kaushalch1/air-monitor/bom.csv

Name | Purpose | Quantity | Total Cost (USD) | Link | Distributor
DS3231M+TRL (SOIC-16W) | Real-time clock | 1 | 8.25 | https://www.lcsc.com/product-detail/C37663.html | LCSC
BMP280 | Pressure sensor | 1 | 6.03 | https://www.lcsc.com/product-detail/C83291.html | LCSC
ESP32-S3-WROOM-1-N16R8 | Main MCU (Wi-Fi/BLE) | 1 | 5.54 | https://www.lcsc.com/product-detail/C2913202.html | LCSC
SHT31-DIS-B2.5kS | Temperature/humidity sensor | 1 | 3.41 | https://www.lcsc.com/product-detail/C80862.html | LCSC
0.91 inch OLED (ER-OLEDM0.91-1W-I2C) | Display | 1 | 2.8 | https://www.buydisplay.com/i2c-white-0-91-inch-oled-display-module-128x32-arduino-raspberry-pi | BuyDisplay
BQ24074RGTR | Li-ion battery charger / power path | 1 | 1.59 | https://www.lcsc.com/product-detail/C54313.html | LCSC
microSD socket (DM3AT-SF-PEJM5) | Data logging storage | 1 | 1.12 | https://www.lcsc.com/product-detail/C114218.html | LCSC
USB-C receptacle (TYPE-C-31-M-12) | USB-C charging and data port | 1 | 0.19 | https://www.lcsc.com/product-detail/C165948.html | LCSC
CR2032 holder (CR2032-BS-6-1) | RTC backup battery holder | 1 | 0.15 | https://www.lcsc.com/product-detail/C70377.html | LCSC
AP2112K-3.3TRG1 | 3.3V LDO regulator | 1 | 0.13 | https://www.lcsc.com/product-detail/C51118.html | LCSC
USBLC6-2SC6 | USB ESD protection | 1 | 0.13 | https://www.lcsc.com/product-detail/C7519.html | LCSC
4.7uH inductor 6.3x6.3mm (proxy: Chilisin MHCI06030-4R7M-R8) | Boost converter inductor | 1 | 0.11 | https://www.lcsc.com/product-detail/C108295.html | LCSC
MT3608 | Boost converter | 1 | 0.08 | https://www.lcsc.com/product-detail/C84817.html | LCSC
SS34 Schottky diode (SMA) | Power path / reverse protection diode | 1 | 0.07 | https://www.lcsc.com/product-detail/C2759883.html | LCSC
Tact switch 6mm THT | User buttons | 3 | 0.1 | https://www.lcsc.com/search?q=tactile+switch+6x6+THT | LCSC
1x8 female socket header 2.54mm | Sensor/expansion header | 1 | 0.08 | https://www.lcsc.com/search?q=1x8+female+header+2.54mm | LCSC
10uF capacitor 0805 | Bulk/decoupling capacitors | 4 | 0.19 | https://www.lcsc.com/product-detail/C15850.html | LCSC
Resistors 0805 (5.1k, 890, 1.5k, 10k, 100k, 75k) | Pull-ups, dividers, config resistors | 11 | 0.05 | https://www.lcsc.com/search?q=0805+1%25+resistor | LCSC
1uF capacitor 0805 | Filter capacitors | 3 | 0.04 | https://www.lcsc.com/search?q=CL21B105KBFNNNE | LCSC
4.7uF capacitor 0805 | Filter capacitor | 1 | 0.03 | https://www.lcsc.com/search?q=CL21A475KAQNNNE | LCSC
100nF capacitor 0805 | IC bypass capacitors | 4 | 0.03 | https://www.lcsc.com/product-detail/C1711.html | LCSC
1x2 pin header 2.54mm | Power/battery header | 1 | 0.02 | https://www.lcsc.com/search?q=1x2+pin+header+2.54mm | LCSC
PCB (bare board) | Main PCB | 1 | 0.4 | https://jlcpcb.com/ | JLCPCB
PCB assembly (PCBA fees) | SMT + through-hole assembly fees | 1 | 8.17 | https://jlcpcb.com/ | JLCPCB
 |  |  | 38.71
