kaushalch1/air-monitor/cad files/air monitor.step

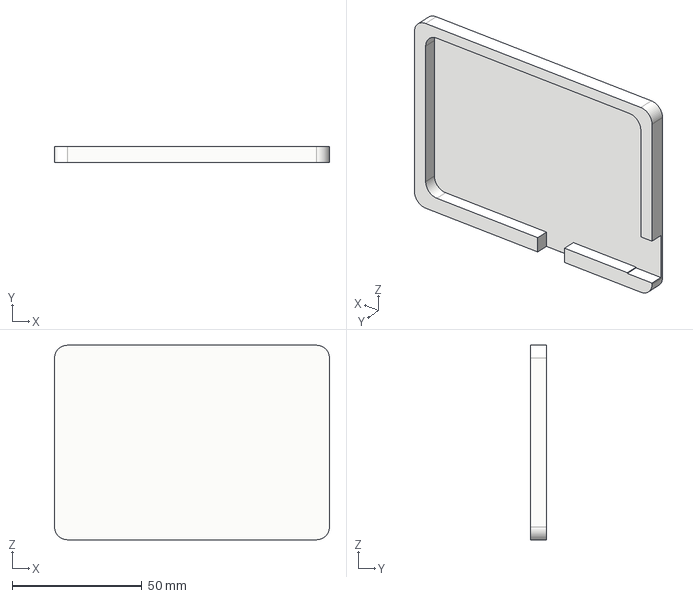
[picture p1: CAD file, 2026-10-24]
cad files/air monitor.step
106.0 x 6.00 x 75.0 mm
