kaushalch1/air-monitor/cad files/air monitor assesmbly model.step

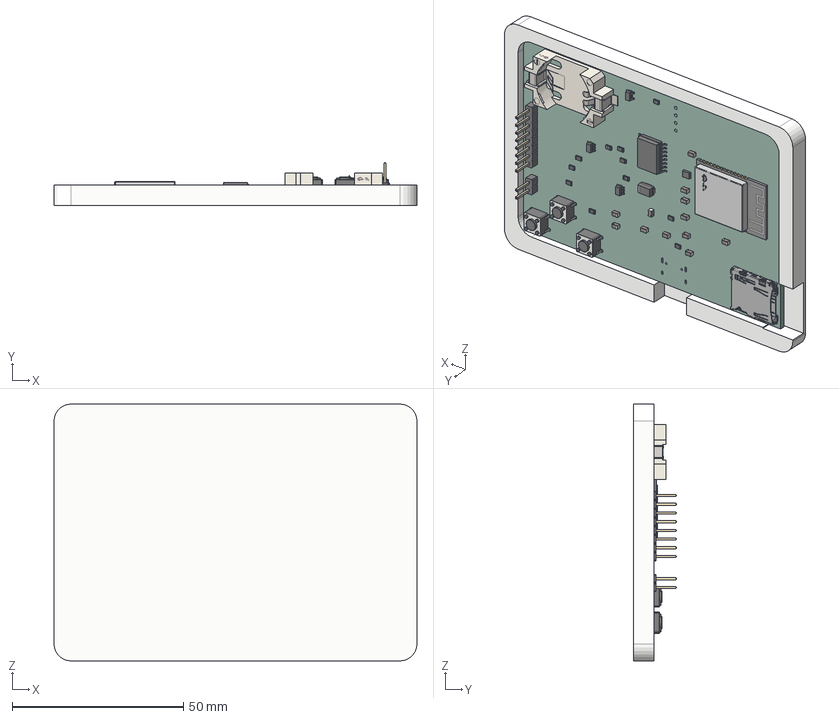
[picture p2: CAD file, 2026-10-24]
cad files/air monitor assesmbly model.step
106.0 x 12.4 x 75.0 mm
SOT-23-6_1 x 2
C_0805_2012Metric_1 x 12
R_0805_2012Metric_1 x 11
BAT-SMD_L28.5-W16.0-H5.5-LS31.3_CR2032-BS-6-1_1
PinHeader_1x08_P254mm_Vertical
SOIC-16W_7.5x10.3mm_P1.27mm_1
D_SMA_1
SW_PUSH_6mm_1 x 3
Bosch_LGA_8_2x25mm_P065mm_ClockwisePinNumbering
PinHeader_1x02_P254mm_Vertical
microSD_HC_Hirose_DM3AT-SF-PEJM5_1
WIRELM-SMD_ESP32-S3-WROOM-1_1
SOT-23-5_1
air monitor_PCB
