kaushalch1/air-monitor/(list of files, cad)

Other CAD files:
cad files/air monitor assesmbly model.f3z
cad files/air monitor.f3d
