kaushalch1/air-monitor/pcb ,gerber files/pcb files/air monitor.kicad_pcb

## KiCad design pcb ,gerber files/pcb files/air monitor.kicad_pcb (2026-10-21)

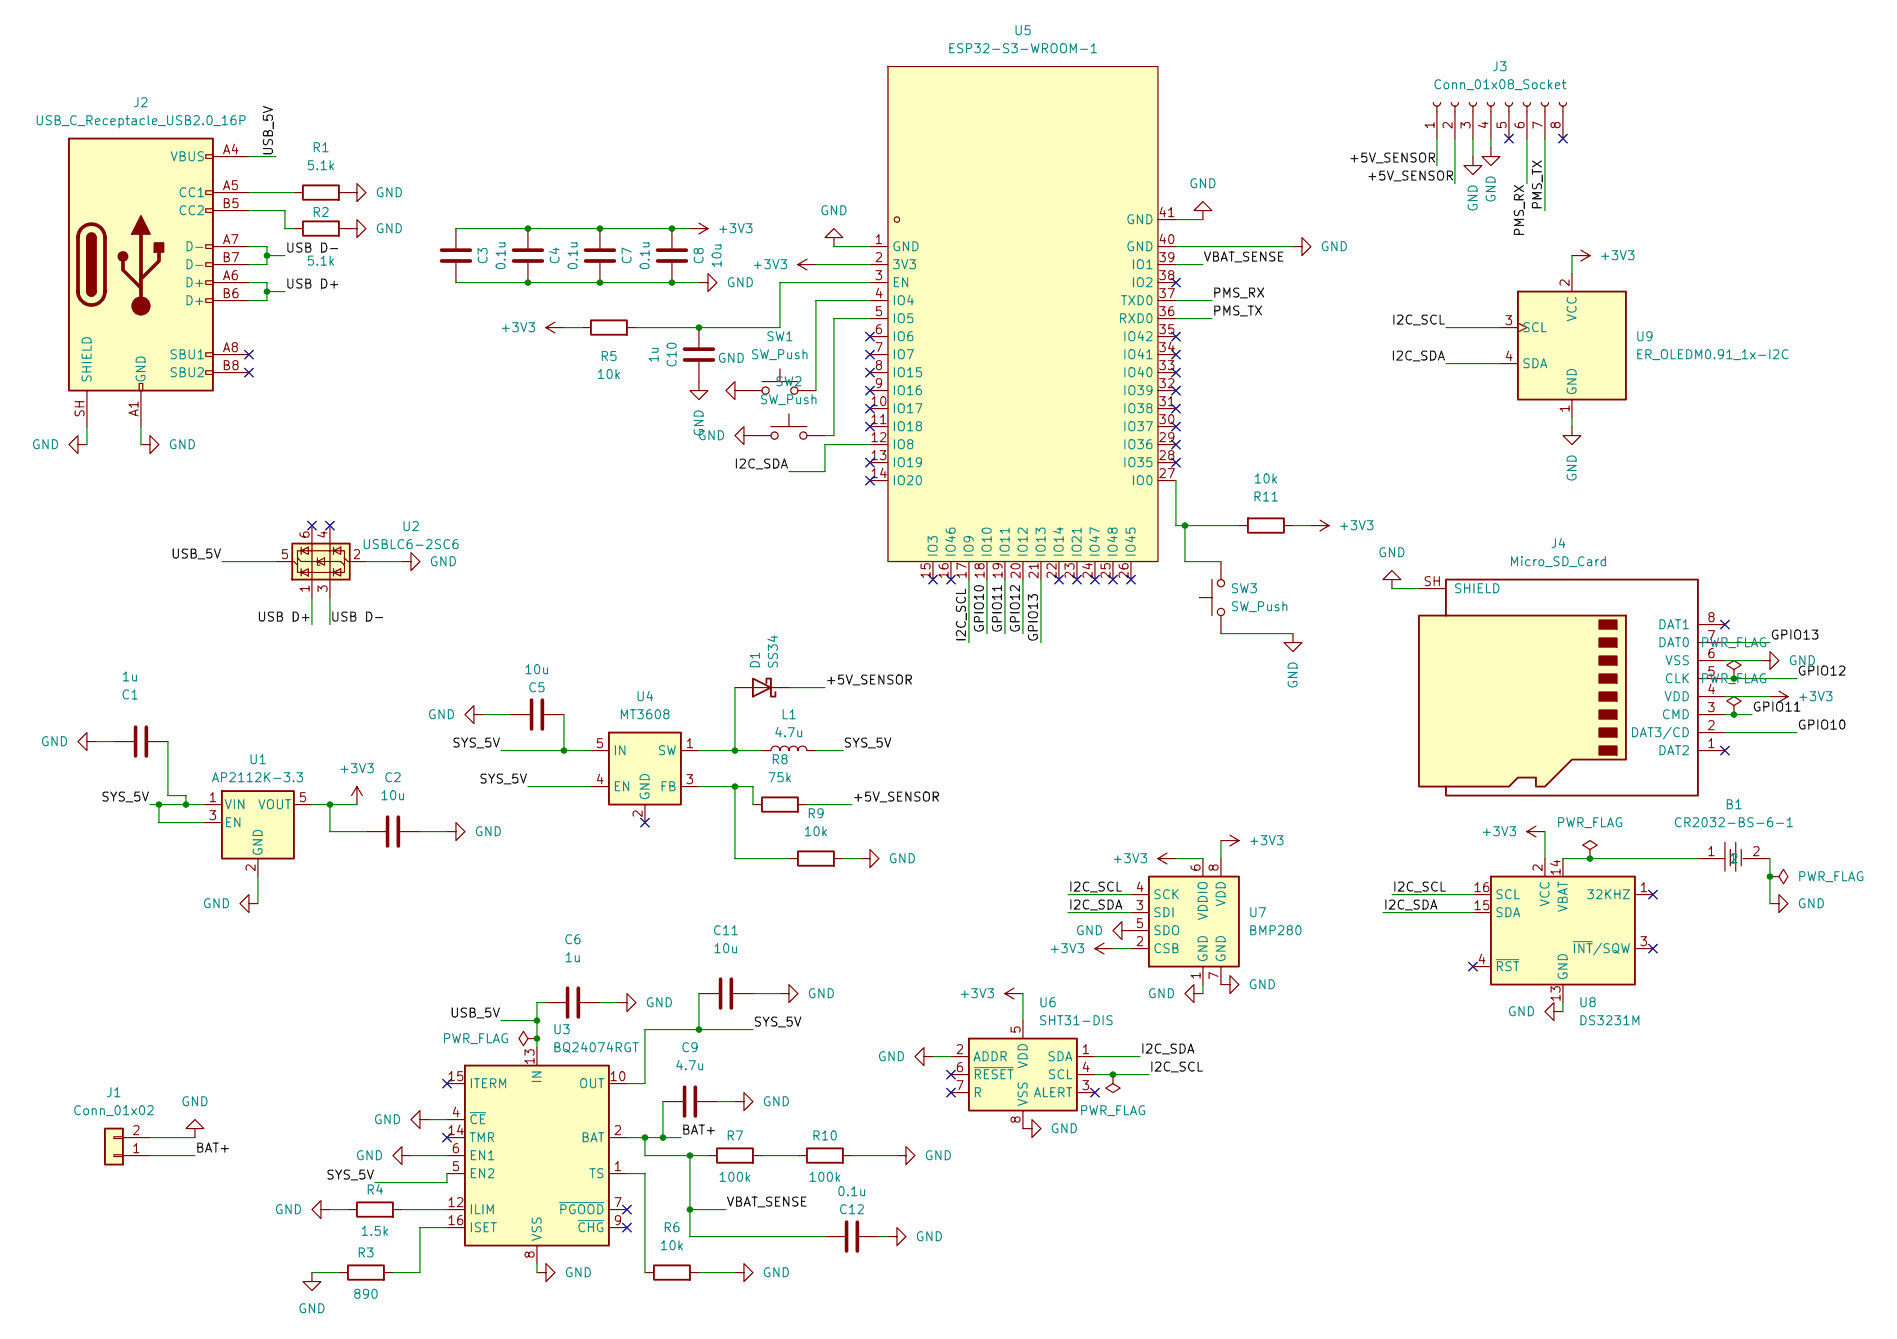
[picture p3: schematic air monitor.kicad_sch]

Parts:
B1: CR2032-BS-6-1; BAT-TH_CR2032-BS-6-1; MPN CR2032-BS-6-1; LCSC Part C70377
C1, C6, C10: 1u; C_0805_2012Metric
C2, C5, C8, C11: 10u; C_0805_2012Metric
C3, C4, C7, C12: 0.1u; C_0805_2012Metric
C9: 4.7u; C_0805_2012Metric
D1: SS34; D_SMA
J1: Conn_01x02; PinHeader_1x02_P2.54mm_Vertical
J2: USB_C_Receptacle_USB2.0_16P; USB_C_Receptacle_HRO_TYPE-C-31-M-12
J3: Conn_01x08_Socket; PinHeader_1x08_P2.54mm_Vertical
J4: Micro_SD_Card; microSD_HC_Hirose_DM3AT-SF-PEJM5
L1: 4.7u; L_6.3x6.3_H3
R1, R2: 5.1k; R_0805_2012Metric
R3: 890; R_0805_2012Metric
R4: 1.5k; R_0805_2012Metric
R5, R6, R9, R11: 10k; R_0805_2012Metric
R7, R10: 100k; R_0805_2012Metric
R8: 75k; R_0805_2012Metric
SW1, SW2, SW3: SW_Push; SW_PUSH_6mm
U1: AP2112K-3.3; SOT-23-5
U2: USBLC6-2SC6; SOT-23-6
U3: BQ24074RGT; VQFN-16-1EP_3x3mm_P0.5mm_EP1.6x1.6mm
U4: MT3608; SOT-23-6
U5: ESP32-S3-WROOM-1; WIRELM-SMD_ESP32-S3-WROOM-1; MPN ESP32-S3-WROOM-1-N16R8; LCSC Part C2913202
U6: SHT31-DIS; Sensirion_DFN-8-1EP_2.5x2.5mm_P0.5mm_EP1.1x1.7mm
U7: BMP280; Bosch_LGA-8_2x2.5mm_P0.65mm_ClockwisePinNumbering
U8: DS3231M; SOIC-16W_7.5x10.3mm_P1.27mm
U9: ER_OLEDM0.91_1x-I2C

Connections:
+3V3: C2.1, C3.2, C4.2, C7.2, C8.2, J4.4 (VDD), R5.1, R11.1, U1.5 (VOUT), U5.2 (3V3), U6.5 (VDD), U7.2 (CSB), U7.6 (VDDIO), U7.8 (VDD), U8.2 (VCC), U9.2 (VCC)
/+5V_SENSOR: D1.1 (K), J3.1, J3.2, R8.2
/BAT+: C9.1, C12.2, J1.1, R7.1, U3.2 (BAT), U3.3 (BAT), U5.39 (IO1)
/GPIO10: J4.2 (DAT3/CD), U5.18 (IO10)
/GPIO11: J4.3 (CMD), U5.19 (IO11)
/GPIO12: J4.5 (CLK), U5.20 (IO12)
/GPIO13: J4.7 (DAT0), U5.21 (IO13)
/I2C_SCL: U5.17 (IO9), U6.4 (SCL), U7.4 (SCK), U8.16 (SCL), U9.3 (SCL)
/I2C_SDA: U5.12 (IO8), U6.1 (SDA), U7.3 (SDI), U8.15 (SDA), U9.4 (SDA)
/PMS_RX: J3.6, U5.37 (TXD0)
/PMS_TX: J3.7, U5.36 (RXD0)
/SYS_5V: C1.1, C5.1, C11.1, L1.2, U1.1 (VIN), U1.3 (EN), U3.5 (EN2), U3.10 (OUT), U3.11 (OUT), U4.4 (EN), U4.5 (IN)
/USB D+: J2.A6 (D+), J2.B6 (D+), U2.1 (I/O1)
/USB D-: J2.A7 (D-), J2.B7 (D-), U2.3 (I/O2)
/USB_5V: C6.1, J2.A4 (VBUS), J2.A9 (VBUS), J2.B4 (VBUS), J2.B9 (VBUS), U2.5 (VBUS), U3.13 (IN)
GND: B1.2, C1.2, C2.2, C3.1, C4.1, C5.2, C6.2, C7.1, C8.1, C9.2, C10.2, C11.2, C12.1, J1.2, J2.A1 (GND), J2.A12 (GND), J2.B1 (GND), J2.B12 (GND), J2.SH (SHIELD), J3.3, J3.4, J4.6 (VSS), J4.SH (SHIELD), R1.2, R2.2, R3.1, R4.1, R6.2, R9.2, R10.2, SW1.1, SW2.1, SW3.1, U1.2 (GND), U2.2 (GND), U3.4 (~CE), U3.6 (EN1), U3.8 (VSS), U3.17 (VSS), U5.1 (GND), U5.40 (GND), U5.41 (GND), U6.2 (ADDR), U6.8 (VSS), U6.9 (VSS), U7.1 (GND), U7.5 (SDO), U7.7 (GND), U8.5 (GND), U8.6 (GND), U8.7 (GND), U8.8 (GND), U8.9 (GND), U8.10 (GND), U8.11 (GND), U8.12 (GND), U8.13 (GND), U9.1 (GND)
unnamed: D1.2 (A), L1.1, U4.1 (SW)
unnamed: J2.A5 (CC1), R1.1
unnamed: J2.B5 (CC2), R2.1
unnamed: R7.2, R10.1
unnamed: R4.2, U3.12 (ILIM)
unnamed: R3.2, U3.16 (ISET)
unnamed: R6.1, U3.1 (TS)
unnamed: R8.1, R9.1, U4.3 (FB)
unnamed: C10.1, R5.2, U5.3 (EN)
unnamed: R11.2, SW3.2, U5.27 (IO0)
unnamed: SW1.2, U5.4 (IO4)
unnamed: SW2.2, U5.5 (IO5)
unnamed: B1.1, U8.14 (VBAT)

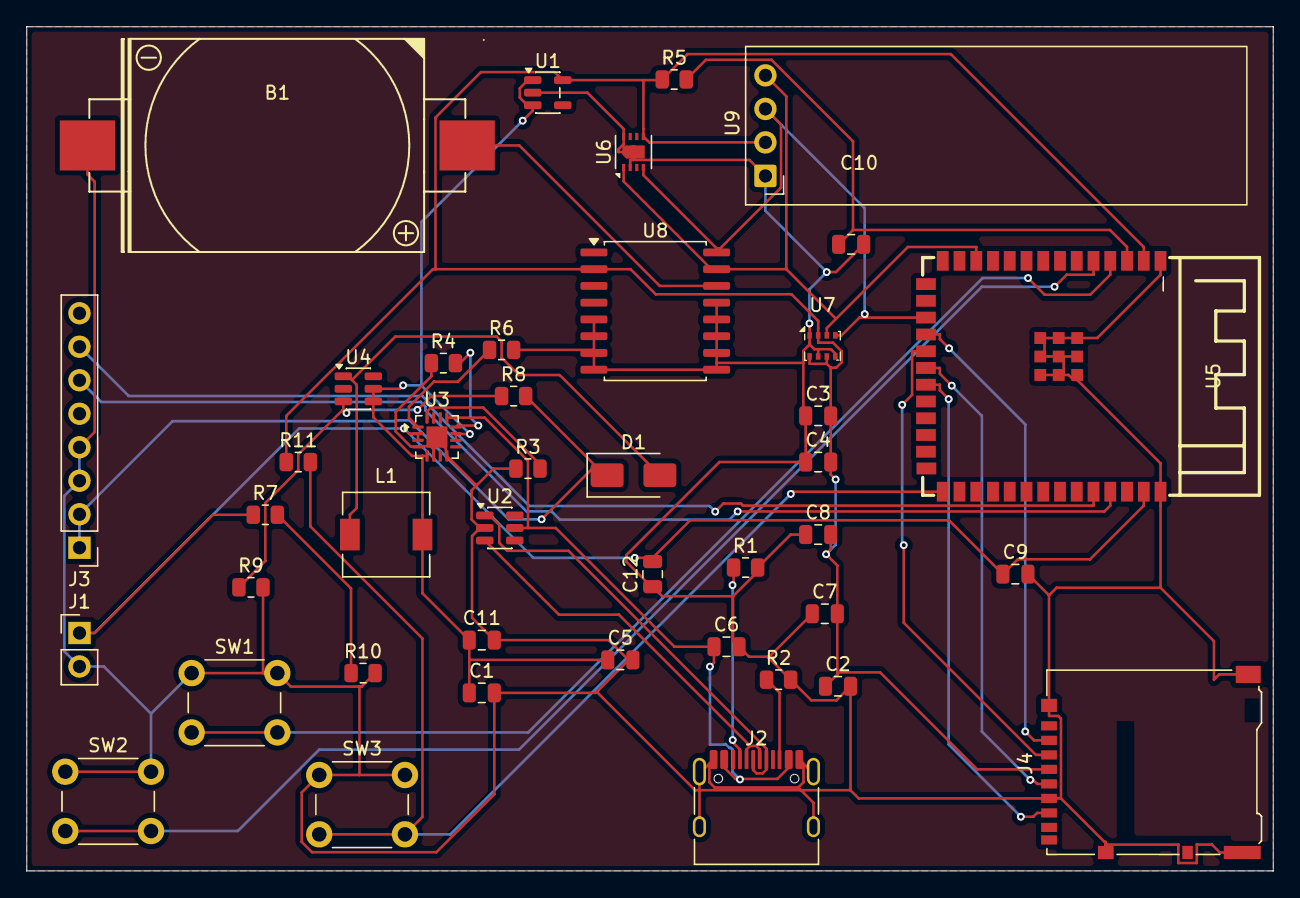
[picture p4: board air monitor.kicad_pcb from above]

Board: 2 copper layers, 94.5 x 64.0 mm, 42 parts (0 on the bottom side), 29 nets.
