kaushalch1/air-monitor/journal.md

# date:19/10
# time spent:1.25hr
## description:
i started put in some researching the architecture for this project.i carefully mapped out how to handle a portable and battery powered diving deep into component datasheetss to choose the bq24074 for smart power path management and defining proper usbc sink behavior, that thorough upfront research made translating the ir monitor and started drawing the schematic.i studied about many air monitor projects and figured out making one

## images:



-------

# date:19/10
# time spent:2hr
## description:
i started the entire project from block 1 by placing the esp32-s3 controller and setting up its essential decoupling and reset passives. from there i got the usbc power input properly hooked up with its sink resistors and esd protection and dialed in the bq24074 battery charger circuit, and carefully walked through the dual voltage regulator stage getting both the 3.3v main rail and the mt3608 5v boost converter complete with its inductor and diode and feedback network totally squared away.

## images:




-------
# date:20/10
# time spent:1.25hr
## description:
In the block 2,i integrated the SHT31 and bmp280 environmental sensors onto a shared i2c bus connected to the esp32-s3 gpioO8 and gpioO9 pins, grounding the sht31 address pin for 0x44, and locking the bmp280 into i2c mode with address 0x76. and then going to block 3,i searched for a particulate sensor i had found many modules but none of these had an symbol in kicad , i tried importing it through a plugin but it didn't work so i successfully set up an 8 pin connector for the pms5003 particulate matter sensor, powering it via the regulated 5V rail and grounding it properly, and cross connecting its uart lines to the microcontroller serial pins.

## images:





-------
# date:20/10
# time spent:1.25hr
## description:
after the particulate sensor integration,i moved straight into block 4 ,i placed and wired the connectors for the ssd1306 oled display, a spi based microsd card module for saving csv data, and a ds3231 real time clock complete with a cr2032 coin cell backup battery for persistent timestamps,i also integrated the user interface navigation buttons and designed a safe battery voltage monitoring circuitand by  using a a voltage divider and a stabilization capacitor connected to the esp32-s3 adc pin.now the schematic is done,i should check for erc and assign footprints.

## images:




-------
# date:20/10
# time spent:0.5hr
## description:
I started fixing all the drc errors there were 50+ errors and i had go through each one and then i fixed all the errors by placing pwr_flag and then i should assign footprints.

## images:




-------
# date:20/10
# time spent:0.5hr
## description:
i had searcched the internet and gathered footprints for all the parts and assigned them for each part and then added them in the pcb.

## images:



-------
# date:21/10
# time spent:0.5hr
## description:
I had started doing the layout by arranging the antenas,usb,microsd card at the edges and now i should route each of them/

## images:


-------
# date:21/10
# time spent:1.5hr
## description:
after arranging the layout i had started doing the routing , i had started routing the micro controllers and then connected the sd card in the nenxt i should connect all of them bby using the ground plate and fill it 
## images:




-------
# date:21/10
# time spent:1.5hr
## description:
after arranging the layout i had started doing the routing , i had started routing the micro controllers and then connected the sd card in the nenxt i should connect all of them bby using the ground plate and fill it 
## images:




-------
# date:21/10
# time spent:1.5hr
## description:
i had completed the routing part of the pcb and also fixed all the erc errors mainly the errors were regarding the unconnected items or the sd card footprint was wrong so i had updated it.
## images:




-------

# date:21/10
# time spent:0.75hr
## description:
i had started making the firmware of the project in the wowki simulator i gathered all the libraries and started making the digram.json file for the project and and adding all sensors to it
## images:



-------
# date:21/10
# time spent:1.75hr
## description:
i studied about how to use cpp in arduino projects and then with the help of ai ,i started learning the coding part of the project and then i had completed the coding part of the project
## images:



-------
# date:21/10
# time spent:0.5hr
## description:
i had added the bom files in the repo by checking in the lscs number and also i i had rendered the gerber files and the dril files and published them in the repo.
## images:


-------
# date:24/10
# time spent:1hr
## description:
as reviewer asked me to make cad case ,i had made  the case for the model and then created an assembly model for the pcb and pusshed the files to the repo
## images:



-------
